citriena/deslemLogger/PCB/dataLoggerV2_1.png

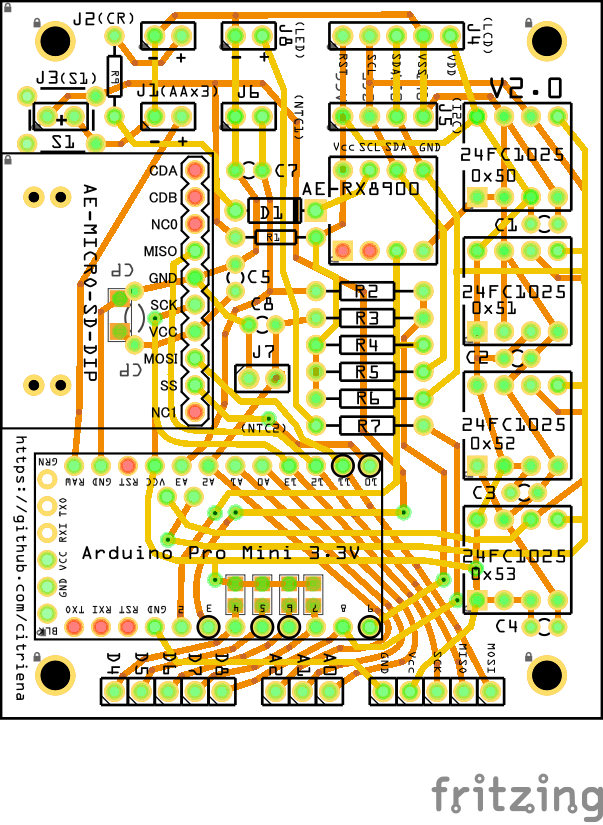
PCB/dataLoggerV2_1.png
