citriena/deslemLogger/lcdSdTemp.ino

//////////////////////////////////////////////////////
// 電池長期間駆動Arduinoロガー
// deslemLogger (deep sleep EEPROM logger)用補助スケッチ
// 使用状況等で変更する設定、複数のソースファイルで共通の設定
// サーミスタ等温度のみのセンサを使う場合のLCD表示，microSDへのデータ書き出しフォーマット設定
// 同じ測定項目の別のセンサーで共用できるようにソースファイルを分離
//////////////////////////////////////////////////////

#ifdef SENSOR_NTC
#ifndef SEKISAN
#ifndef MIN_MAX

//////////////////////////////////////////////////////
//          display time to lcd                     //
//////////////////////////////////////////////////////

#define DECIMAL_PLACE 1

void lcdTime(tmElements_t tm, lcdTimeMode_t mode, char cursorColumn) {
  if (mode != DATA_TIME_MODE) {  // メニュー導入画面，時計設定モード時は年も表示
    lcd.print(tmYearToCalendar(tm.Year));
    lcd.print(F("/"));
  }
  if (tm.Month < 10) lcd.print(F("0"));
  lcd.print(tm.Month);
  lcd.print(F("/"));
  if (tm.Day < 10) lcd.print(F("0"));
  lcd.print(tm.Day);
  if (mode == DATA_TIME_MODE) { // 時分は
    lcd.setCursor(0, 1);        // 表示モード時は２行目
  } else {
    lcd.print(F(" "));          // 設定モード時はスペースを空けて続ける。
  }
  if (tm.Hour < 10) lcd.print(F("0"));
  lcd.print(tm.Hour, DEC);
  lcd.print(F(":"));
  if (tm.Minute < 10) lcd.print(F("0"));
  lcd.print(tm.Minute, DEC);
  lcd.print(F("  "));
  if (cursorColumn >= 0) {
    lcd.setCursor(cursorColumn, 0);
    lcd.blink();
  }
}


//////////////////////////////////////////////////////
//          display data to lcd                     //
//////////////////////////////////////////////////////
void lcdData(data_t tData) {
  if (gDispMode >= CONFIG_NO) return; // RTC割り込みでデータ処理後に通常はデータを表示するが、設定表示、メニュー時は表示しない。
  lcd.setCursor(6, 0);
//  lcd.print(F("A"));
  if (tData.dt1a == NULLDATA_MARK) {
    lcd.print(F(":ERR  "));
  } else {
    if ((tData.dt1a < 10) && (tData.dt1a >= 0)) lcd.print(F(" "));
    lcd.print(tData.dt1a, DECIMAL_PLACE);
    lcd.print(F("C "));
  }
#ifdef DUAL_SENSORS
  lcd.setCursor(6, 1);
//  lcd.print(F("B"));
  if (tData.dt2a == NULLDATA_MARK) {
    lcd.print(F(":ERR  "));
  } else {
    if ((tData.dt2a < 10)  && (tData.dt2a >= 0)) lcd.print(F(" "));
    lcd.print(tData.dt2a, DECIMAL_PLACE);
    lcd.print(F("C "));
  }
#endif // DUAL_SENSORS
}
  // 0123456789abcdef
  // 04/22 25.0C 100%
  // 12:00 30.0C  80%


#endif // MIN_MAX
#endif // SEKISAN

////////////////////////////////////////////////////
//   write xEEPROM log data to SD with date       //
////////////////////////////////////////////////////
void writeFieldName() {
  logfile.println(F("Date,Time,Temp(C)"));
}


void writeLog2SD(tmElements_t tm, data_t tData, intervalUnit_t tLogIntervalUnit) {

  logfile.print(tmYearToCalendar(tm.Year), DEC);
  logfile.print(F("/"));
  logfile.print(tm.Month, DEC);
  logfile.print(F("/"));
  logfile.print(tm.Day, DEC);
  logfile.print(F(","));
  logfile.print(tm.Hour, DEC);
  logfile.print(F(":"));
  logfile.print(tm.Minute, DEC);
  if (tLogIntervalUnit == SEC_INTERVAL) {
    logfile.print(F(":"));
    logfile.print(tm.Second, DEC);
  }
  logfile.print(F(","));
  if (tData.dt1a != NULLDATA_MARK) {
    logfile.print(tData.dt1a, 1);
  }
#ifdef DUAL_SENSORS
  logfile.print(F(","));
  if (tData.dt2a != NULLDATA_MARK) {
    logfile.print(tData.dt2a, 1);
  }
#endif // DUAL_SENSORS
  logfile.println();
}
#endif // SENSOR_NTC
