citriena/deslemLogger/(commit log)

2021-10-09 Revert "show data usage in SHORI menu"
    This reverts commit ba468771f44f9da27d4bb147ffde2dddee404cf7.
    [deslemLogger.ino]
2021-10-24 fix & add
    fix EEPROM to SD routine
    add logging condition display
    [deslemLogger.ino, deslemLoggerConfig.h, lcdSdCO2.ino, lcdSdTemp.ino, lcdSdTempRhAp.ino, lcdSdTempRhCO2.ino, lcdSub.ino, sekisan.ino]
2021-10-27 v1.2.1
    fix WRITE ONCE MODE bug
    [deslemLogger.ino, lcdSdTempRh.ino, timeLibSub.cpp, timeLibSub.h]
2021-10-28 V1.2.2
    EEPROM２周目先頭がヘッダ時の動作修正
2022-12-14 V1.4.0
    Implemented maximum‐minimum thermometer
